RFStateSide/RayRailSwSense/docs/licensing.md

# Licensing

Copyright RF StateSide LLC. Original RayRailSwSense hardware contributions and
associated engineering source documentation are provided under CERN Open
Hardware Licence Version 2 — Permissive, SPDX **CERN-OHL-P-2.0**.

The unmodified [LICENSE](../LICENSE) is authoritative. [NOTICE](../NOTICE)
records attribution and preparation changes. Retain applicable notices and
identify modifications when distributing derived material as required by the
license. This explanation does not replace its terms.

The owner approved this license for the original hardware. That approval does
not mark the prepared engineering package or its documentation as accepted.

Stock/upstream KiCad library material has separate terms and its library
exception. Preserve [library notices](../hardware/libraries/README.md).
See [provenance](provenance.md); no license is asserted over unrelated firmware,
supplier documents or omitted vendor models.

The official text is copyright CERN 2020. It is preserved byte-for-byte from
the approved reference package, with its source and checksum in
[license provenance](license-provenance.json). Manufacturing outputs include
matching LICENSE and NOTICE files.

This AS-IS reference promises no certification, guaranteed performance,
continued development or support. Section 5 of the official license governs
warranty and liability provisions subject to its stated limits.
