RFStateSide/RayRailSwSense/bom/README.md

# Population BOM

RayRailSwSense.csv describes the owner-confirmed BTH500301LUAAUMA1 population.
R4 is 2 kΩ; FB1 is BLM31PG121SN1L, DigiKey 490-1056-1-ND. The PCB retains the
historical FB1 lands; read the assembly note rather than assuming a standard
1206 footprint. F1 identifies the holder, not the separate removable fuse.

The tested fuse was 25 A, 32 VDC automotive type. Its manufacturer, exact series
and time/current curve are unrecorded. This is not evidence of a continuous
25 A test. Choose protection for the actual circuit within all component limits.

BTH500151LUAAUMA1 is an unverified alternative to U1. It is not a second
qualified board-current variant and requires different current-sense calibration.

Other manufacturer and supplier fields are retained procurement references,
not proof of every historical fitted part. U1 tape/reel procurement is a current
reference, not a claim about the packaging originally purchased. Mechanical
mounting features H1–H4 are part of the PCB, excluded from the electronic BOM
and placement file.
