RFStateSide/RayRailSwSense/hardware/RayRailSwSense.kicad_pcb

## KiCad design hardware/RayRailSwSense.kicad_pcb (2026-10-12)

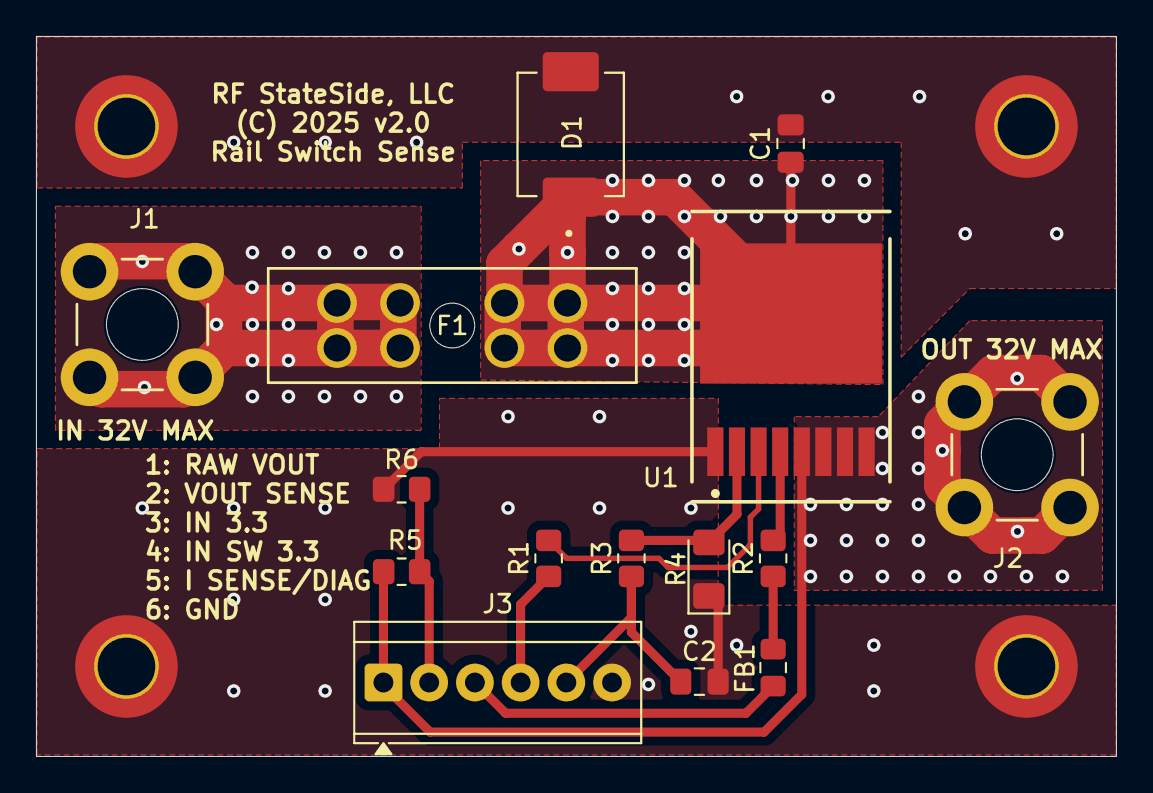
[picture p1: board RayRailSwSense.kicad_pcb from above]

Board: 2 copper layers, 60.0 x 40.0 mm, 19 parts (0 on the bottom side), 12 nets.

Parts:
C1: .1 µF; Capacitor_SMD_C_0805_2012Metric_Pad1.18x1.45mm_HandSolder
C2: .01 µF; Capacitor_SMD_C_0805_2012Metric_Pad1.18x1.45mm_HandSolder
D1: SMCJ85A; MyFootprints_DIOM7959X262N
F1: 178.6165.0002; MyFootprints_FUSE_178.6165.0002_LTF
FB1: BLM31PG121SN1L; Inductor_SMD_L_0805_2012Metric_Pad1.15x1.40mm_HandSolder
H1, H2, H3, H4: MountingHole_3.2mm_M3_ISO7380_Pad_TopBottom_Gnd; MyFootprints_MountingHole_3.2mm_M3_ISO7380_Pad_TopBottom_Gnd
J1, J2: 74650074R; MyFootprints_CONN_74650074R_WRE
J3: Screw_Terminal_01x06; TerminalBlock_TE-Connectivity_TerminalBlock_TE_282834-6_1x0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
R1, R2, R3, R6: 4.7K; Resistor_SMD_R_0805_2012Metric_Pad1.20x1.40mm_HandSolder
R4: 2k; LED_SMD_LED_1206_3216Metric_Pad1.42x1.75mm_HandSolder
R5: 82K; Resistor_SMD_R_0805_2012Metric_Pad1.20x1.40mm_HandSolder
U1: BTH50030-1LUA; MyFootprints_IFX-PG-HSOF-5-6-7-8

Connections:
+3.3V: FB1.1, R2.1
+VDC: J2.1, J2.2, J2.3, J2.4, J3.1, R5.2, U1.5 (OUT1), U1.6 (OUT2), U1.7 (OUT3), U1.8 (OUT4)
GND: C1.2, C2.2, D1.A, H1.1, H2.1, H3.1, H4.1, J3.6, R4.1, R6.1, U1.1 (GND)
unnamed: F1.1, F1.2, F1.3, F1.4, J1.1, J1.2, J1.3, J1.4
unnamed: J3.2, R5.1, R6.2
unnamed: FB1.2, J3.3
unnamed: J3.4, R1.1
unnamed: C2.1, J3.5, R3.1
unnamed: R2.2, U1.4 (DEN)
unnamed: R1.2, U1.3 (IN)
unnamed: R3.2, R4.2, U1.2 (IS)
unnamed: C1.1, D1.C, F1.5, F1.6, F1.7, F1.8, U1.9 (VS)
