RFStateSide/RayRailSwSense/(notices)

Notices in the files:
hardware/RayRailSwSense.kicad_pcb:
(C) 2025 v2.0
